cameronus/flight-computer-2/3d/4020.stp

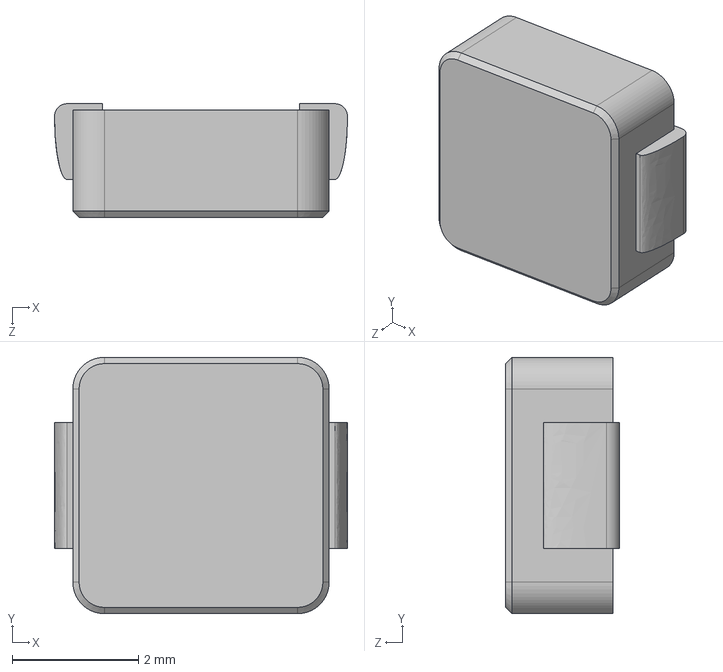
[picture p1: CAD file, 2021-01-25]
3d/4020.stp
4.64 x 4.06 x 1.80 mm
