cameronus/flight-computer-2/3d/SW_PTS810_SJM_250_SMTR_LFS.stp

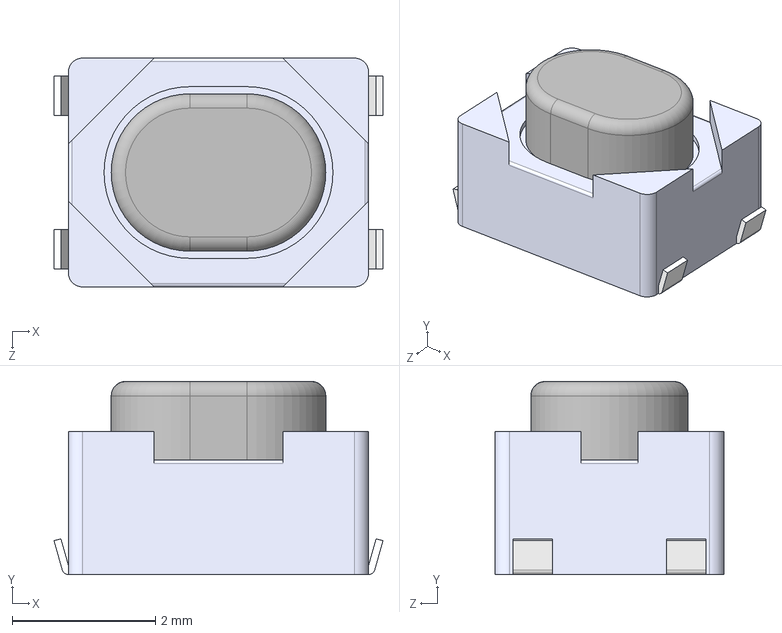
[picture p2: CAD file, 2020-07-31]
3d/SW_PTS810_SJM_250_SMTR_LFS.stp
4.60 x 2.70 x 3.20 mm
