cameronus/flight-computer-2/3d/47948-0001.stp

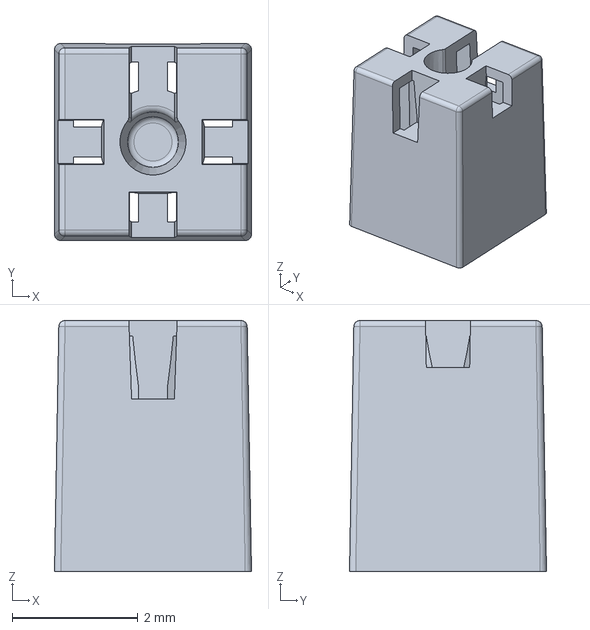
[picture p3: CAD file, 2020-07-31]
3d/47948-0001.stp
3.14 x 3.14 x 4.00 mm
