cameronus/flight-computer-2/abacus.kicad_pcb

## KiCad design abacus.kicad_pcb (2021-01-26)

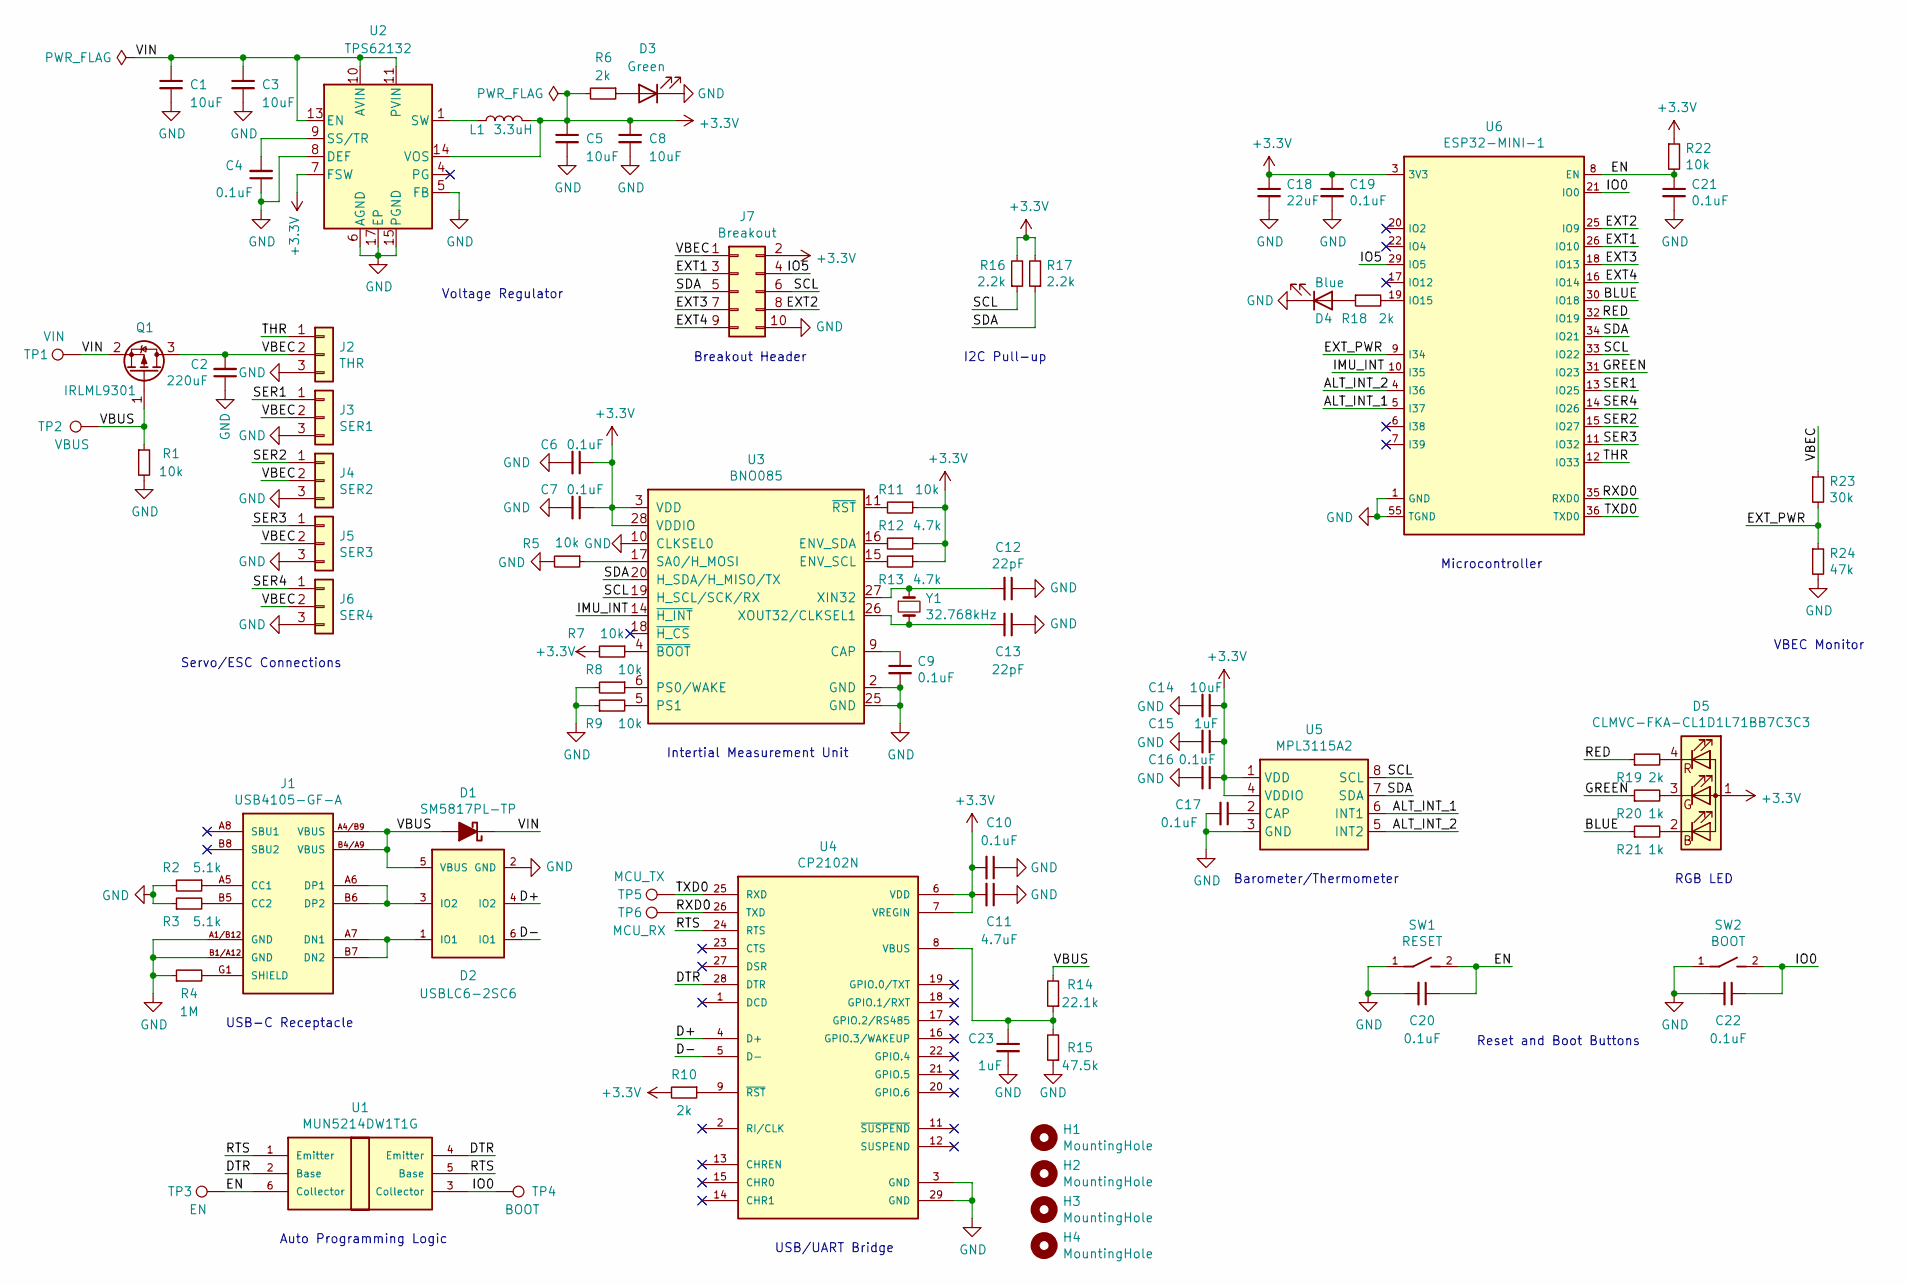
[picture p4: schematic abacus.sch, Abacus Flight Computer]

Parts:
C1, C3, C5, C8, C14: 10uF; C_0805_2012Metric; MPN CL21B106KOQNNNE
C2: 220uF; C_1206_3216Metric; MPN GRM31CR60J227ME11L
C4, C6, C7, C9, C10, C16, C17, C19, C20, C21, C22: 0.1uF; C_0603_1608Metric; MPN CL10B104KB8NNNC
C11: 4.7uF; C_0603_1608Metric; MPN CL10B475KQ8NQNC
C12, C13: 22pF; C_0603_1608Metric; MPN C0603C220K4GACTU
C15, C23: 1uF; C_0603_1608Metric; MPN CL10B105KP8NNNC
C18: 22uF; C_1206_3216Metric; MPN CL31B226KPHNNNE
D1: SM5817PL-TP; D_SOD-123F; MPN SM5817PL-TP
D2: USBLC6-2SC6; SOT-23-6; MPN USBLC6-2SC6
D3: Green; LED_0603_1608Metric; MPN LTST-C191KGKT
D4: Blue; LED_0603_1608Metric; MPN LTST-C191TBKT
D5: CLMVC-FKA-CL1D1L71BB7C3C3; LED_Cree-PLCC4_2x2mm_CW; MPN CLMVC-FKA-CL1D1L71BB7C3C3
H1, H2, H3, H4: MountingHole; MountingHole_2.2mm_M2_Pad
J1: USB4105-GF-A; GCT_USB4105-GF-A; MPN USB4105-GF-A
J2: THR; PinHeader_1x03_P2.54mm_Vertical
J3: SER1; PinHeader_1x03_P2.54mm_Vertical
J4: SER2; PinHeader_1x03_P2.54mm_Vertical
J5: SER3; PinHeader_1x03_P2.54mm_Vertical
J6: SER4; PinHeader_1x03_P2.54mm_Vertical
J7: Breakout; PinHeader_2x05_P2.54mm_Vertical
L1: 3.3uH; 0420CDMCCDS; MPN 0420CDMCCDS-3R3MC
Q1: IRLML9301; SOT-23; MPN IRLML9301
R1, R5, R7, R8, R9, R11, R22: 10k; R_0603_1608Metric; MPN RC0603FR-0710KL
R2, R3: 5.1k; R_0603_1608Metric; MPN RC0603FR-075K1L
R4: 1M; R_0603_1608Metric; MPN RC0603FR-071ML
R6, R10, R18, R19: 2k; R_0603_1608Metric; MPN RC0603FR-072KL
R12, R13: 4.7k; R_0603_1608Metric; MPN RC0603FR-074K7L
R14: 22.1k; R_0603_1608Metric; MPN RC0603FR-0722K1L
R15: 47.5k; R_0603_1608Metric; MPN RC0603FR-0747K5L
R16, R17: 2.2k; R_0603_1608Metric; MPN RC0603FR-072K2L
R20, R21: 1k; R_0603_1608Metric; MPN RC0603FR-071KL
R23: 30k; R_0603_1608Metric; MPN RC0603FR-0730KL
R24: 47k; R_0603_1608Metric; MPN RC0603FR-0747KL
SW1: RESET; SW_SPST_PTS810; MPN PTS810 SJK 250 SMTR LFS
SW2: BOOT; SW_SPST_PTS810; MPN PTS810 SJK 250 SMTR LFS
TP1: VIN; TestPoint_Pad_D1.5mm
TP2: VBUS; TestPoint_Pad_D1.5mm
TP3: EN; TestPoint_Pad_D1.5mm
TP4: BOOT; TestPoint_Pad_D1.5mm
TP5: MCU_TX; TestPoint_Pad_D1.5mm
TP6: MCU_RX; TestPoint_Pad_D1.5mm
U1: MUN5214DW1T1G; SOT-363_SC-70-6; MPN MUN5214DW1T1G
U2: TPS62132; VQFN-16-1EP_3x3mm_P0.5mm_EP1.68x1.68mm_ThermalVias; MPN TPS62132RGTR
U3: BNO085; LGA-28_5.2x3.8mm_P0.5mm; MPN BNO085
U4: CP2102N; QFN-28-1EP_5x5mm_P0.5mm_EP3.35x3.35mm; MPN CP2102N-A02-GQFN28R
U5: MPL3115A2; LGA-8_3x5mm_P1.25mm; MPN MPL3115A2R1
U6: ESP32-MINI-1; MPN ESP32-MINI-1
Y1: 32.768kHz; ABS07; MPN ABS07-32.768KHZ-1-T

Connections:
+3V3: C5.1, C6.1, C7.1, C8.1, C10.2, C11.2, C14.1, C15.1, C16.1, C18.1, C19.1, D5.1 (A), J7.2, L1.2, R6.2, R7.2, R10.2, R11.1, R12.1, R13.1, R16.2, R17.2, R22.1, U2.7 (FSW), U2.14 (VOS), U3.3 (VDD), U3.28 (VDDIO), U4.6 (VDD), U4.7 (VREGIN), U5.1 (VDD), U5.4 (VDDIO), U6.3 (3V3)
/ALT_INT_1: U5.6 (INT1), U6.5 (I37)
/ALT_INT_2: U5.5 (INT2), U6.4 (I36)
/BLUE: R21.1, U6.30 (IO18)
/D+: D2.4 (IO2), U4.4 (D+)
/D-: D2.6 (IO1), U4.5 (D-)
/DTR: U1.2 (Base), U1.4 (Emitter), U4.28 (DTR)
/EN: C20.1, C21.1, R22.2, SW1.2, TP3.1, U1.6 (Collector), U6.8 (EN)
/EXT1: J7.3, U6.26 (IO10)
/EXT2: J7.8, U6.25 (IO9)
/EXT3: J7.7, U6.18 (IO13)
/EXT4: J7.9, U6.16 (IO14)
/EXT_PWR: R23.2, R24.1, U6.9 (I34)
/GREEN: R20.1, U6.31 (IO23)
/IMU_INT: U3.14 (~H_INT), U6.10 (I35)
/IO0: C22.1, SW2.2, TP4.1, U1.3 (Collector), U6.21 (IO0)
/IO5: J7.4, U6.29 (IO5)
/RED: R19.1, U6.32 (IO19)
/RTS: U1.1 (Emitter), U1.5 (Base), U4.24 (RTS)
/RXD0: TP6.1, U4.26 (TXD), U6.35 (RXD0); also elsewhere on the board
/SCL: J7.6, R16.1, U3.19 (H_SCL/SCK/RX), U5.8 (SCL), U6.33 (IO22)
/SDA: J7.5, R17.1, U3.20 (H_SDA/H_MISO/TX), U5.7 (SDA), U6.34 (IO21)
/SER1: J3.1, U6.13 (IO25)
/SER2: J4.1, U6.15 (IO27)
/SER3: J5.1, U6.11 (IO32)
/SER4: J6.1, U6.14 (IO26)
/THR: J2.1, U6.12 (IO33)
/TXD0: TP5.1, U4.25 (RXD), U6.36 (TXD0); also elsewhere on the board
/VBEC: C2.2, J2.2, J3.2, J4.2, J5.2, J6.2, J7.1, Q1.3 (D), R23.1
/VBUS: D1.2 (A), D2.5 (VBUS), J1.A4/B9 (VBUS), J1.B4/A9 (VBUS), Q1.1 (G), R1.1, R14.2, TP2.1; also elsewhere on the board
/VIN: C1.1, C3.1, D1.1 (K), Q1.2 (S), TP1.1, U2.10 (AVIN), U2.11 (PVIN), U2.12 (PVIN), U2.13 (EN); also elsewhere on the board
GND: C1.2, C2.1, C3.2, C4.1, C5.2, C6.2, C7.2, C8.2, C9.2, C10.1, C11.1, C12.1, C13.1, C14.2, C15.2, C16.2, C17.2, C18.2, C19.2, C20.2, C21.2, C22.2, C23.2, D2.2 (GND), D3.1 (K), D4.1 (K), J1.A1/B12 (GND), J1.B1/A12 (GND), J2.3, J3.3, J4.3, J5.3, J6.3, J7.10, R1.2, R2.2, R3.1, R4.1, R5.2, R8.2, R9.1, R15.1, R24.2, SW1.1, SW2.1, U2.5 (FB), U2.6 (AGND), U2.8 (DEF), U2.15 (PGND), U2.16 (PGND), U2.17 (EP), U3.2 (GND), U3.10 (CLKSEL0), U3.25 (GND), U4.3 (GND), U4.29 (GND), U5.3 (GND), U6.1 (GND), U6.2 (GND), U6.27 (GND), U6.38 (GND), U6.39 (GND), U6.40 (GND), U6.41 (GND), U6.42 (GND), U6.43 (GND), U6.44 (GND), U6.45 (GND), U6.46 (GND), U6.47 (GND), U6.48 (GND), U6.49 (GND), U6.50 (GND), U6.51 (GND), U6.52 (GND), U6.53 (GND), U6.54 (GND), U6.55 (TGND)
unnamed: C4.2, U2.9 (SS/TR)
unnamed: C9.1, U3.9 (CAP)
unnamed: C12.2, U3.27 (XIN32), Y1.1
unnamed: C13.2, U3.26 (XOUT32/CLKSEL1), Y1.2
unnamed: C17.1, U5.2 (CAP)
unnamed: C23.1, R14.1, R15.2, U4.8 (VBUS)
unnamed: D2.1 (IO1), J1.A7 (DN1), J1.B7 (DN2)
unnamed: D2.3 (IO2), J1.A6 (DP1), J1.B6 (DP2)
unnamed: D3.2 (A), R6.1
unnamed: D4.2 (A), R18.1
unnamed: D5.2 (B), R21.2
unnamed: D5.3 (G), R20.2
unnamed: D5.4 (R), R19.2
unnamed: J1.A5 (CC1), R2.1
unnamed: J1.B5 (CC2), R3.2
unnamed: J1.G1 (SHIELD), J1.G2 (SHIELD), J1.G3 (SHIELD), J1.G4 (SHIELD), R4.2
unnamed: L1.1, U2.1 (SW), U2.2 (SW), U2.3 (SW)
unnamed: R5.1, U3.17 (SA0/H_MOSI)
unnamed: R7.1, U3.4 (~BOOT)
unnamed: R8.1, U3.6 (PS0/WAKE)
unnamed: R9.2, U3.5 (PS1)
unnamed: R10.1, U4.9 (~RST~)
unnamed: R11.2, U3.11 (~RST)
unnamed: R12.2, U3.16 (ENV_SDA)
unnamed: R13.2, U3.15 (ENV_SCL)
unnamed: R18.2, U6.19 (IO15)

Notes on the sheet:
Voltage Regulator
Servo/ESC Connections
USB-C Receptacle
Intertial Measurement Unit
USB/UART Bridge
Auto Programming Logic
Barometer/Thermometer
Reset and Boot Buttons
I2C Pull-up
RGB LED
Breakout Header
VBEC Monitor
Microcontroller

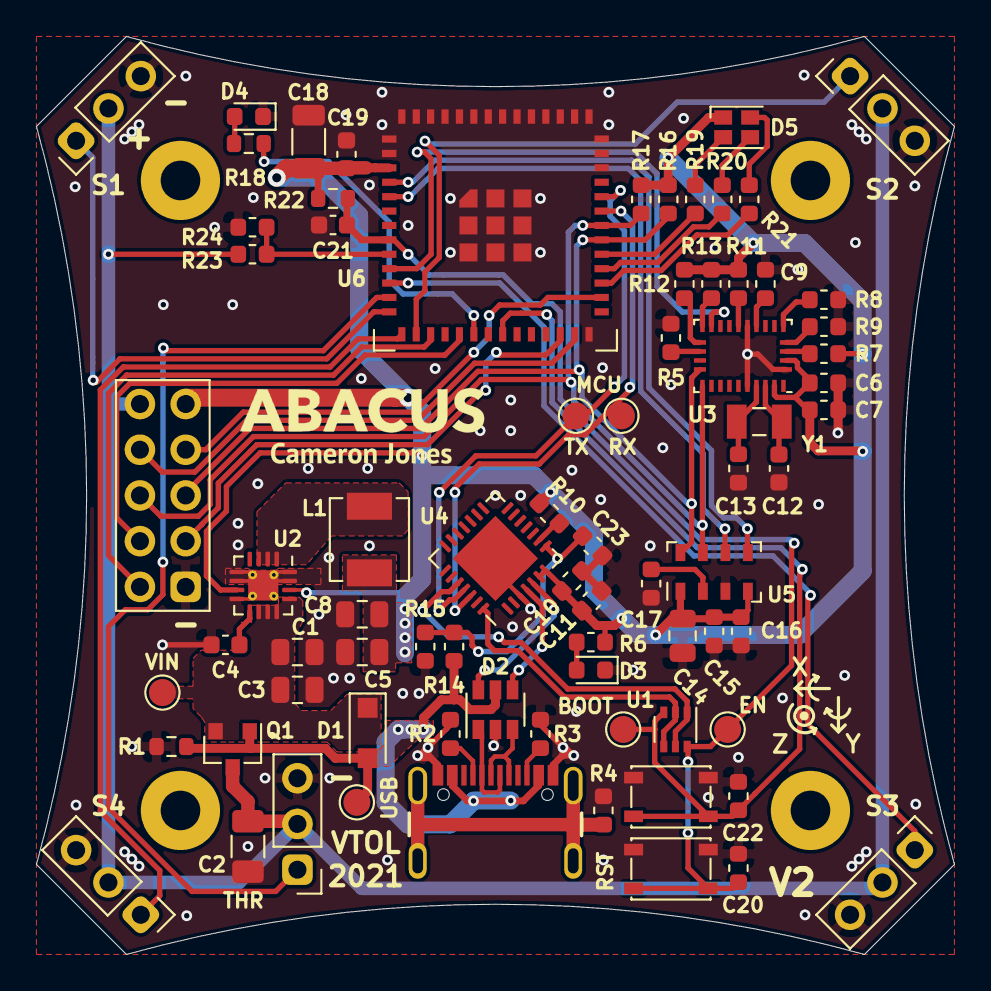
[picture p5: board abacus.kicad_pcb from above]

Board: 2 copper layers, 51.0 x 51.0 mm, 80 parts (0 on the bottom side), 58 nets.

Other parts of the board:
RX: MCU_RX; TestPoint_Pad_D1.5mm
TX: MCU_TX; TestPoint_Pad_D1.5mm
USB: VBUS; TestPoint_Pad_D1.5mm
VIN: VIN; TestPoint_Pad_D1.5mm

Their connections:
/RXD0: RX.1; also elsewhere on the board
/TXD0: TX.1; also elsewhere on the board
/VBUS: USB.1; also elsewhere on the board
/VIN: VIN.1; also elsewhere on the board
