cameronus/flight-computer-2/(commit log)

2020-07-16 New USB symbol
    [flight-computer-2.sch]
2020-07-16 Finishing MCU portion of schematic
    [flight-computer-2.sch]
2020-07-16 Fixed ERC issues
    [flight-computer-2.sch]
2020-07-18 IMU and barometer circuitry
    [flight-computer-2.sch]
2020-07-18 Servo capacitors
    [flight-computer-2.sch]
2020-07-18 Fixed ERC errors
    [flight-computer-2.sch]
2020-07-18 Labels and USB/UART bridge correction
    [flight-computer-2.sch]
2020-07-19 Switched diode and added current limiting resistors
    [flight-computer-2.sch]
2020-07-19 New microSD card symbol
    [flight-computer-2.sch]
2020-07-20 Added RGB LED
    [flight-computer-2.sch]
2020-07-21 I2C lines and new servo power filtering caps
    [flight-computer-2.sch]
2020-07-21 Associating MPNs with symbols
    [flight-computer-2.sch]
2020-07-24 Pin assignments
    [flight-computer-2.sch]
2020-07-24 Breakout headers
    [flight-computer-2.sch]
2020-07-25 Created footprint library
    [flight-computer-2.sch]
2020-07-25 Connecting interrupt pins
    [flight-computer-2.sch]
2020-07-25 Assigning footprints
    [flight-computer-2.sch]
2020-07-29 New USB ESD protection IC
    [flight-computer-2.sch]
2020-07-29 New antenna
    [flight-computer-2.sch]
2020-07-30 New voltage regulator and diode
    [flight-computer-2.kicad_pcb, flight-computer-2.sch]
2020-07-30 MOSFET to detect external power
    [flight-computer-2.sch]
2020-07-30 Voltage divider and updated servo inrush resistors
    [flight-computer-2.sch]
2020-07-30 Rough PCB layout
    [flight-computer-2.kicad_pcb, flight-computer-2.sch]
2020-07-30 Mounting holes and more component placement
    [flight-computer-2.kicad_pcb, flight-computer-2.sch]
2020-07-30 Adjusting 3D model offset and more placement
    [flight-computer-2.kicad_pcb]
2020-07-30 More placement and footprint updates
    [flight-computer-2.kicad_pcb]
2020-07-30 Finished preliminary placement
    [flight-computer-2.kicad_pcb, flight-computer-2.sch]
2020-07-31 More layout and routing
    [flight-computer-2.kicad_pcb, flight-computer-2.sch]
2020-07-31 USB/UART routing complete
    [flight-computer-2.kicad_pcb]
2020-07-31 MCU and sensor routing
    [flight-computer-2.kicad_pcb]
2020-07-31 Restarting routing with smaller passive footprints
    [flight-computer-2.kicad_pcb, flight-computer-2.sch]
2020-07-31 New 3D models and testing placement
    [47948-0001.stp, SW_PTS810_SJM_250_SMTR_LFS.stp, flight-computer-2.kicad_pcb]
2020-08-01 Further arrangement and new MCU footprint
    [flight-computer-2.kicad_pcb, flight-computer-2.sch]
2020-08-01 More optimization
    [flight-computer-2.kicad_pcb, flight-computer-2.sch]
2020-08-01 Upscaled to 0603 passives
    [flight-computer-2.kicad_pcb, flight-computer-2.sch]
2020-08-01 USB/Vreg routing
    [flight-computer-2.kicad_pcb]
2020-08-01 MCU routing partially complete
    [flight-computer-2.kicad_pcb]
2020-08-01 Fixed footprint of ESP32
    [flight-computer-2.kicad_pcb, flight-computer-2.sch]
2020-08-01 Centered ICs and rerouted traces
    [flight-computer-2.kicad_pcb]
2020-08-01 3D model for crystal
    [flight-computer-2.kicad_pcb]
2020-08-02 I2C and other crucial signals routed
    [flight-computer-2.kicad_pcb]
2020-08-02 Refactoring pin mapping
    [flight-computer-2.kicad_pcb, flight-computer-2.sch]
2020-08-02 Rerouting progress
    [flight-computer-2.kicad_pcb, flight-computer-2.sch]
2020-08-02 Final draft of routing complete
    [flight-computer-2.kicad_pcb]
2020-08-03 Small adjustments and IC silkscreen
    [flight-computer-2.kicad_pcb]
2020-08-03 VBEC power filtering cap
    [flight-computer-2.kicad_pcb, flight-computer-2.sch]
2020-08-03 Fixed reference silkscreen
    [flight-computer-2.kicad_pcb]
2020-08-04 Finished top silkscreen and enabled bottom layers
    [flight-computer-2.kicad_pcb]
2020-08-04 Fix strapping pin being pulled high to prevent boot failure
    [flight-computer-2.kicad_pcb, flight-computer-2.sch]
2020-08-04 Better solution to strapping pin issue
    [flight-computer-2.kicad_pcb, flight-computer-2.sch]
2020-08-04 Small routing changes
    [flight-computer-2.kicad_pcb]
2020-08-04 New power filtering cap and minor routing adjustments
    [flight-computer-2.kicad_pcb, flight-computer-2.sch]
2020-08-04 Removing programming selector resistors
    [flight-computer-2.kicad_pcb, flight-computer-2.sch]
2020-08-04 More vias near antenna pads
    [flight-computer-2.kicad_pcb]
2020-08-05 Added MPNs for passives and modified SW symbols
    [flight-computer-2.kicad_pcb, flight-computer-2.sch]
2020-08-05 Readded 3D model for buttons
    [flight-computer-2.kicad_pcb, flight-computer-2.sch]
2020-08-05 More silkscreen fixes and switched MPN
    [flight-computer-2.kicad_pcb, flight-computer-2.sch]
2020-08-05 Small routing change
    [flight-computer-2.kicad_pcb]
2020-08-05 Gerbers, BOM, and centroid file
    [flight-computer-2-B_Cu.gbl, flight-computer-2-B_Mask.gbs, flight-computer-2-B_Paste.gbp, flight-computer-2-B_SilkS.gbo, flight-computer-2-Edge_Cuts.gm1, flight-computer-2-F_Cu.gtl, flight-computer-2-F_Mask.gts, flight-computer-2-F_Paste.gtp]
2020-08-07 IMU axis marker and small routing changes
    [flight-computer-2.kicad_pcb]
2020-08-07 New graphics/gerbers/centroid file
    [flight-computer-2-B_Cu.gbl, flight-computer-2-B_Mask.gbs, flight-computer-2-B_Paste.gbp, flight-computer-2-B_SilkS.gbo, flight-computer-2-Edge_Cuts.gm1, flight-computer-2-F_Cu.gtl, flight-computer-2-F_Mask.gts, flight-computer-2-F_Paste.gtp]
2020-08-09 Servo labels and microstrip grounding vias
    [flight-computer-2.kicad_pcb]
2020-08-29 Small routing/silk changes
    [flight-computer-2.kicad_pcb]
2021-01-17 Switching to ESP32-MINI-1 module
    [flight-computer-2.kicad_pcb, flight-computer-2.sch]
2021-01-18 Status LED and breakout pins
    [flight-computer-2.sch]
2021-01-18 BNO upgrade and address selection
    [flight-computer-2.sch]
2021-01-20 DCDC regulator and reverse current MOSFET
    [flight-computer-2.sch]
2021-01-21 Updated annotations and parts
    [flight-computer-2.sch]
2021-01-21 Update switch actuation force
    [flight-computer-2.sch]
2021-01-21 New parts, annotation
    [flight-computer-2.sch]
2021-01-22 Fix footprint association
    [flight-computer-2.sch]
2021-01-22 Updated PCB with new netlist/footprints
    [flight-computer-2.kicad_pcb]
2021-01-23 Layout and fixing passive footprint
    [flight-computer-2.kicad_pcb, flight-computer-2.sch]
2021-01-24 Layout and routing
    [flight-computer-2.kicad_pcb, flight-computer-2.sch]
2021-01-25 Routing draft
    [flight-computer-2-B_Cu.gbl, flight-computer-2-B_Mask.gbs, flight-computer-2-B_Paste.gbp, flight-computer-2-B_SilkS.gbo, flight-computer-2-Edge_Cuts.gm1, flight-computer-2-F_Cu.gtl, flight-computer-2-F_Mask.gts, flight-computer-2-F_Paste.gtp]
2021-01-25 Cleaning up routing
    [flight-computer-2.kicad_pcb, flight-computer-2.sch]
2021-01-25 More refinement
    [flight-computer-2.kicad_pcb]
2021-01-25 Finalizing routing
    [flight-computer-2.kicad_pcb, flight-computer-2.sch]
2021-01-25 Improved grounding
    [flight-computer-2.kicad_pcb]
2021-01-25 Grounding and layout refinement
    [flight-computer-2.kicad_pcb]
2021-01-25 Inductor 3D model
    [4020.stp, flight-computer-2.kicad_pcb]
2021-01-25 Opened thermal vias and fixed routing bug
    [flight-computer-2.kicad_pcb]
2021-01-25 Switching regulator 3D model
    [flight-computer-2.kicad_pcb]
2021-01-25 Silkscreen labels
    [flight-computer-2.kicad_pcb]
2021-01-26 Final touches and gerbers
    [flight-computer-2-B_Cu.gbl, flight-computer-2-B_Mask.gbs, flight-computer-2-B_Paste.gbp, flight-computer-2-B_SilkS.gbo, flight-computer-2-Edge_Cuts.gm1, flight-computer-2-F_Cu.gtl, flight-computer-2-F_Mask.gts, flight-computer-2-F_Paste.gtp]
2021-01-26 More labels
    [flight-computer-2-B_Cu.gbl, flight-computer-2-B_Mask.gbs, flight-computer-2-B_Paste.gbp, flight-computer-2-B_SilkS.gbo, flight-computer-2-Edge_Cuts.gm1, flight-computer-2-F_Cu.gtl, flight-computer-2-F_Mask.gts, flight-computer-2-F_Paste.gtp]
2021-01-26 Updated BOM
    [flight-computer-2.csv]
2021-01-28 Interactive BOM
2021-02-07 Renaming project
    [abacus-B_Cu.gbl, abacus-B_Mask.gbs, abacus-B_Paste.gbp, abacus-B_SilkS.gbo, abacus-Edge_Cuts.gm1, abacus-F_Cu.gtl, abacus-F_Mask.gts, abacus-F_Paste.gtp]
