cameronus/flight-computer-2/(notices)

Notices in the files:
3d/47948-0001.stp:
FILE_NAME( 'C:/Users/KMIROS~1/AppData/Local/Temp/psolqas_13904_34.stp', '2020-04-30T07:18:08', ( 'License CC BY-ND 4.0' ), ( 'CADENAS' ), ' ', 'PARTsolutions', ' ' );
